macgeeknz/maslowdro/box-layer3.jpg

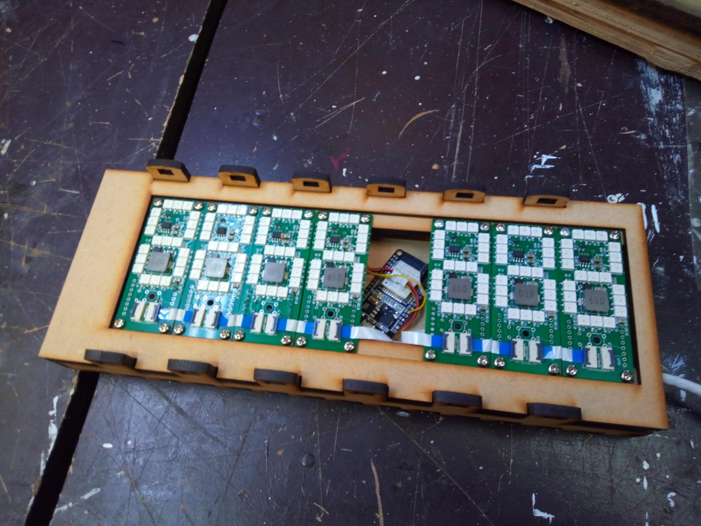
box-layer3.jpg
