macgeeknz/maslowdro/Z.jpg

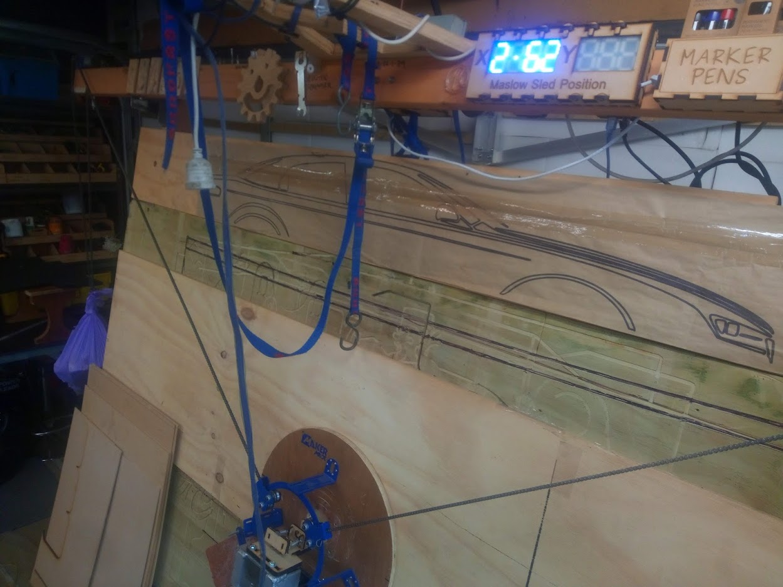
Z.jpg
