macgeeknz/maslowdro/arduino-end.jpg

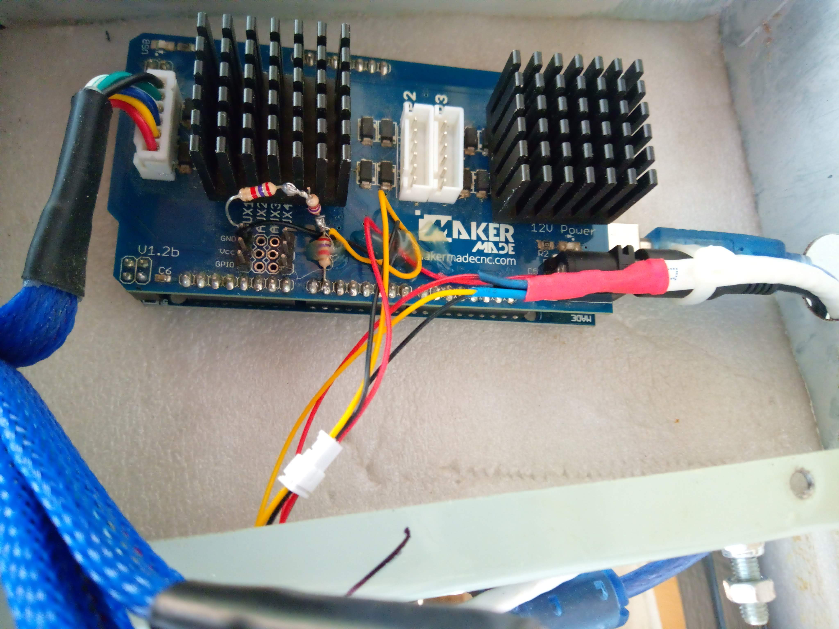
arduino-end.jpg
