macgeeknz/maslowdro/box-layer1.jpg

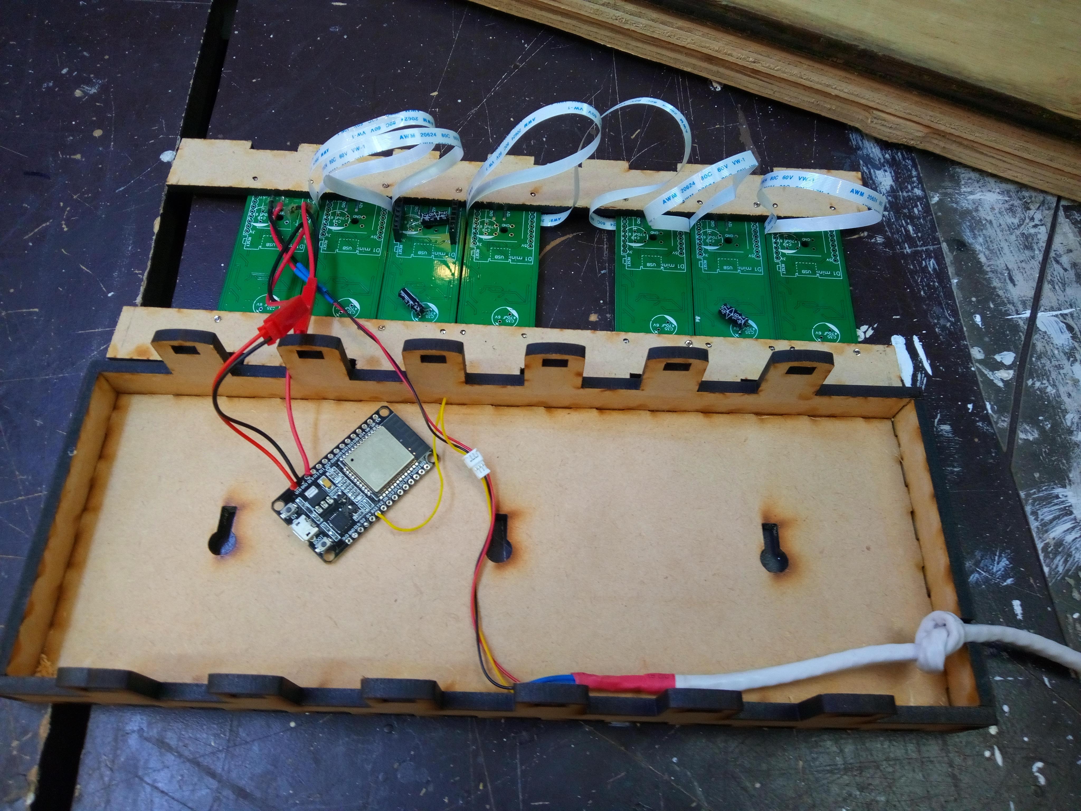
box-layer1.jpg
