macgeeknz/maslowdro/box-layer2.jpg

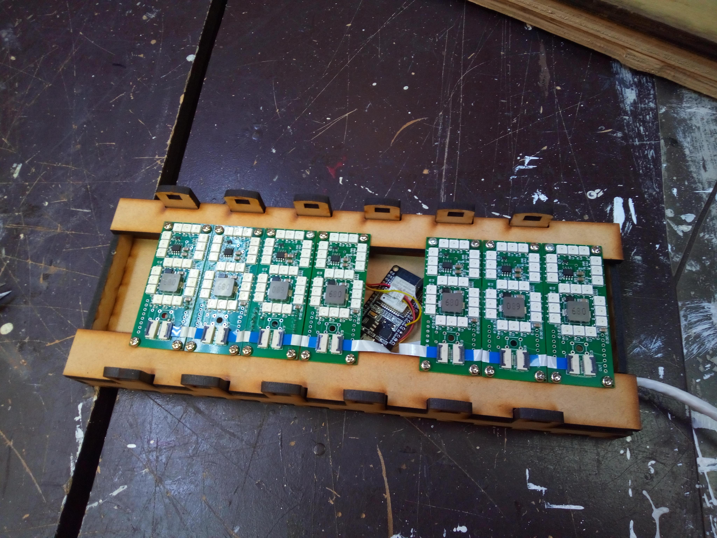
box-layer2.jpg
