macgeeknz/maslowdro/box-layer4.jpg

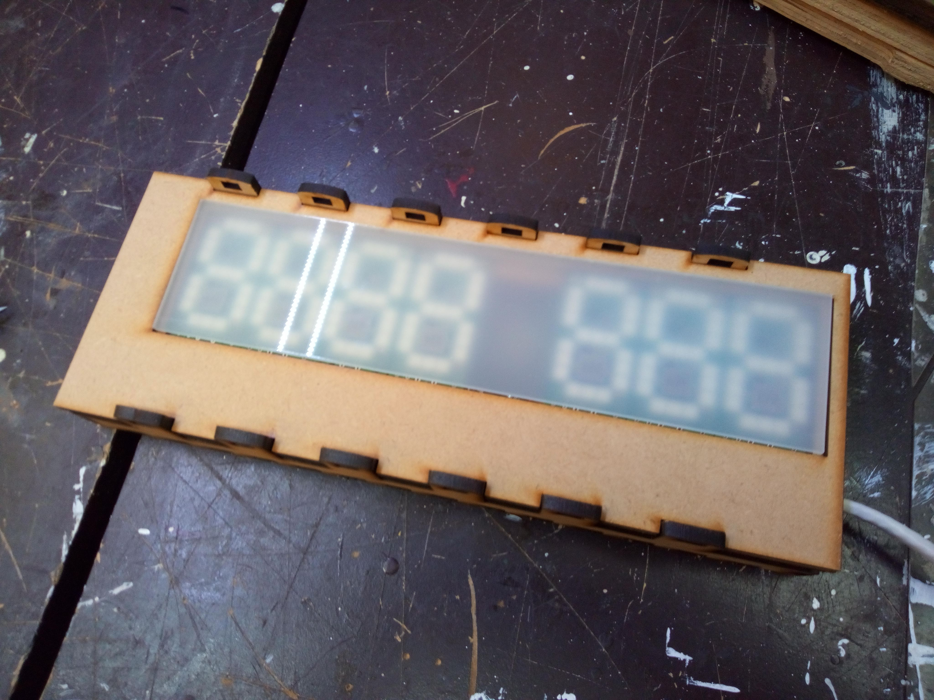
box-layer4.jpg
