macgeeknz/maslowdro/box-layer5.jpg

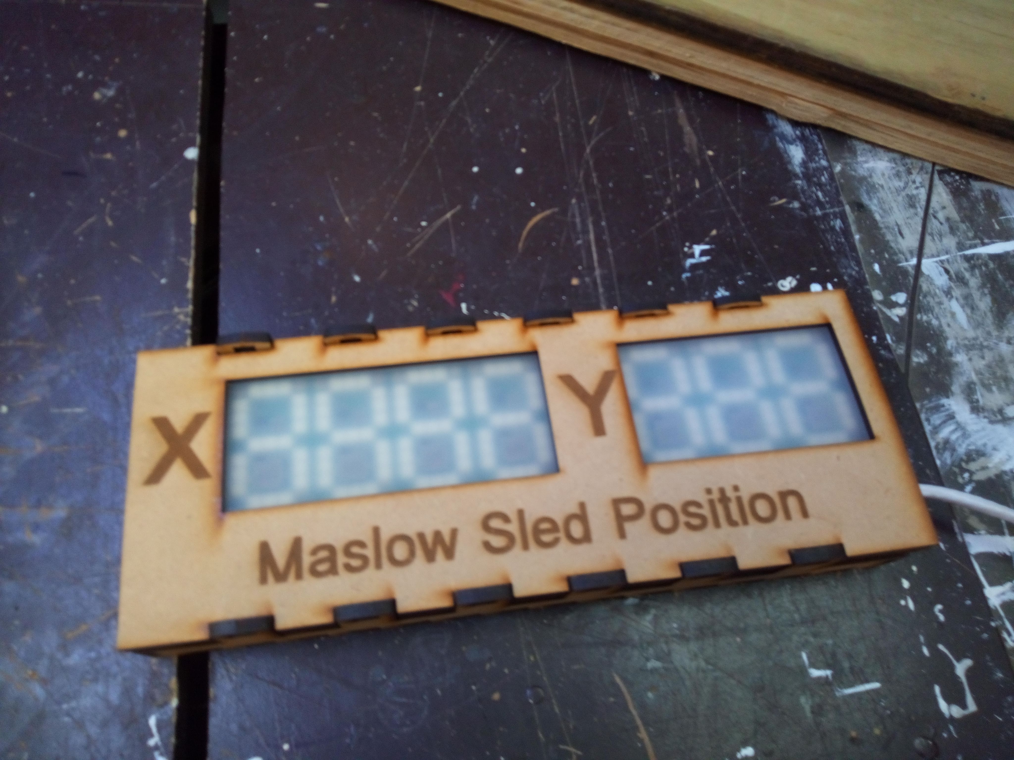
box-layer5.jpg
