macgeeknz/maslowdro/box-layer6.jpg

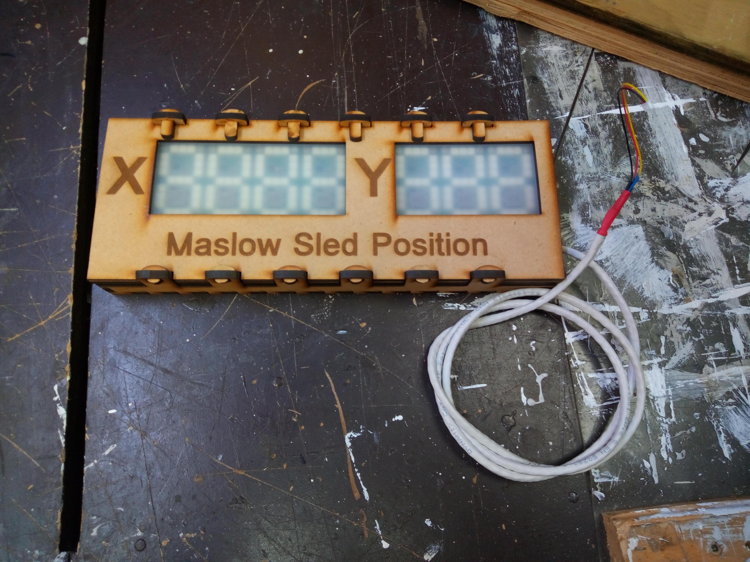
box-layer6.jpg
