macgeeknz/maslowdro/esp32-end.jpg

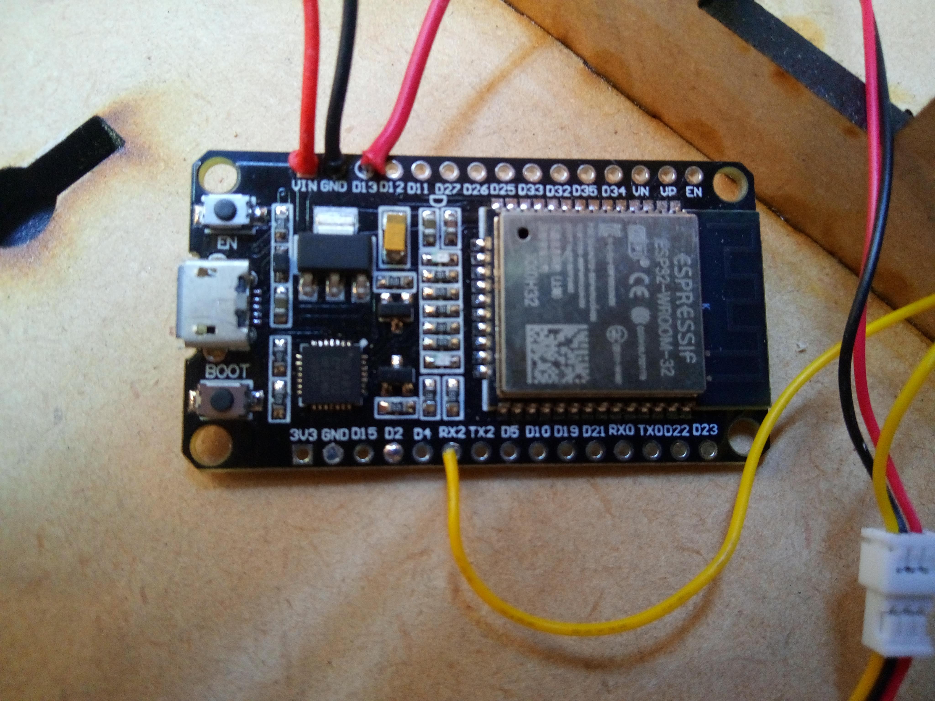
esp32-end.jpg
