macgeeknz/maslowdro/RX-line-resistors.jpg

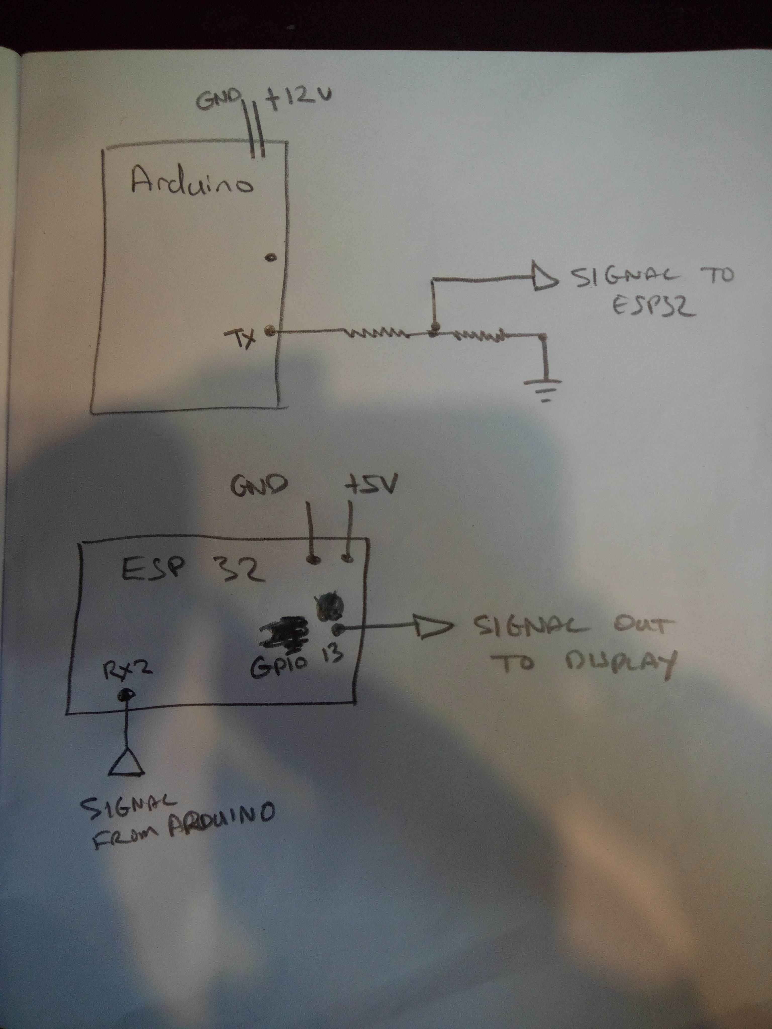
RX-line-resistors.jpg
