macgeeknz/maslowdro/XY.jpg

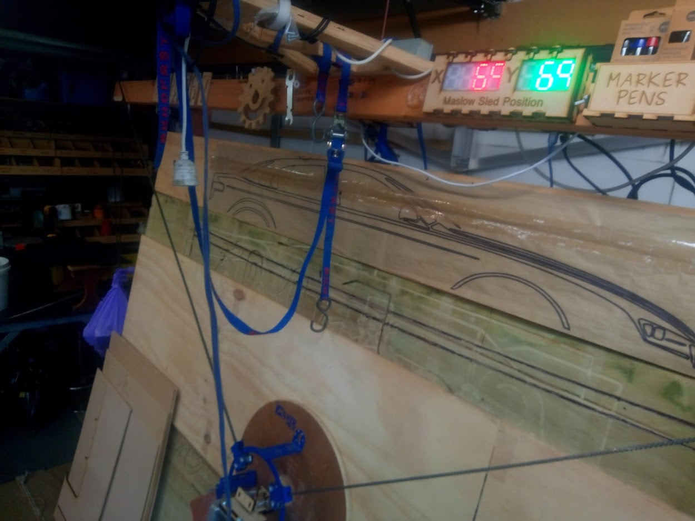
XY.jpg
