macgeeknz/maslowdro/pcb-BOM.csv

ID | Name | Designator | Footprint | Quantity | Manufacturer Part | Manufacturer | Supplier | Supplier Part | Price
1 | F0502-B-10-20T-R | FPC1,FPC2 | FPC-SMD_10P-P0.50_L5.9-W9.4 | 2 | F0502-B-10-20T-R | XFCN | LCSC | C481219 | 0.017
2 | 100uF | C1,C64,C65,C66 | C1206 | 4 | CL31A107MQHNNNE | SAMSUNG | LCSC | C15008 | 0.011
3 | 1uF | C2,C3,C4,C5,C6,C7,C8,C9,C10,C11,C12,C13,C14,C15,C16,C17,C18,C19,C20,C21,C22,C23,C50,C54,C58,C59 | C0402 | 26 | CL05A105KA5NQNC | SAMSUNG | LCSC | C52923 | 0.001
4 | SS34_C8678 | D1 | DO-214AC_L4.3-W2.7-LS5.3-RD | 1 | SS34 | MDD | LCSC | C8678 | 0.005
5 | 68uH | L1 | IND-SMD_L11.5-W10.0_SMMS1040 | 1 | SMMS1040-680MT | ShunXiang Connaught Elec | LCSC | C286354 | 0.042
6 | XL-5050RGBC-WS2812B | LED1,LED2,LED3,LED4,LED5,LED6,LED7,LED8,LED9,LED10,LED11,LED12,LED13,LED14,LED15,LED16,LED17,LED18,LED19,LED20,LED21 | LED-SMD_4P-L5.0-W5.0-BL_XL-5050RGBC | 21 | XL-5050RGBC-WS2812B | XINGLIGHT(成兴光) | LCSC | C2843785 | 0.009
7 | AO3401A | Q4 | SOT-23_L2.9-W1.3-P1.90-LS2.4-BR | 1 | AO3401A | AOS | LCSC | C15127 | 0.014
8 | 10kΩ | R11 | R0402 | 1 | 0402WGF1002TCE | UniOhm | LCSC | C25744
9 | XL1509-5.0E1 | U1 | SOIC-8_L5.0-W4.0-P1.27-LS6.0-BL | 1 | XL1509-5.0E1 | XLSEMI | LCSC | C61063 | 0.03
