macgeeknz/maslowdro/Schematic_1DigitRGBDisplay Rev 2_2023-02-02.pdf

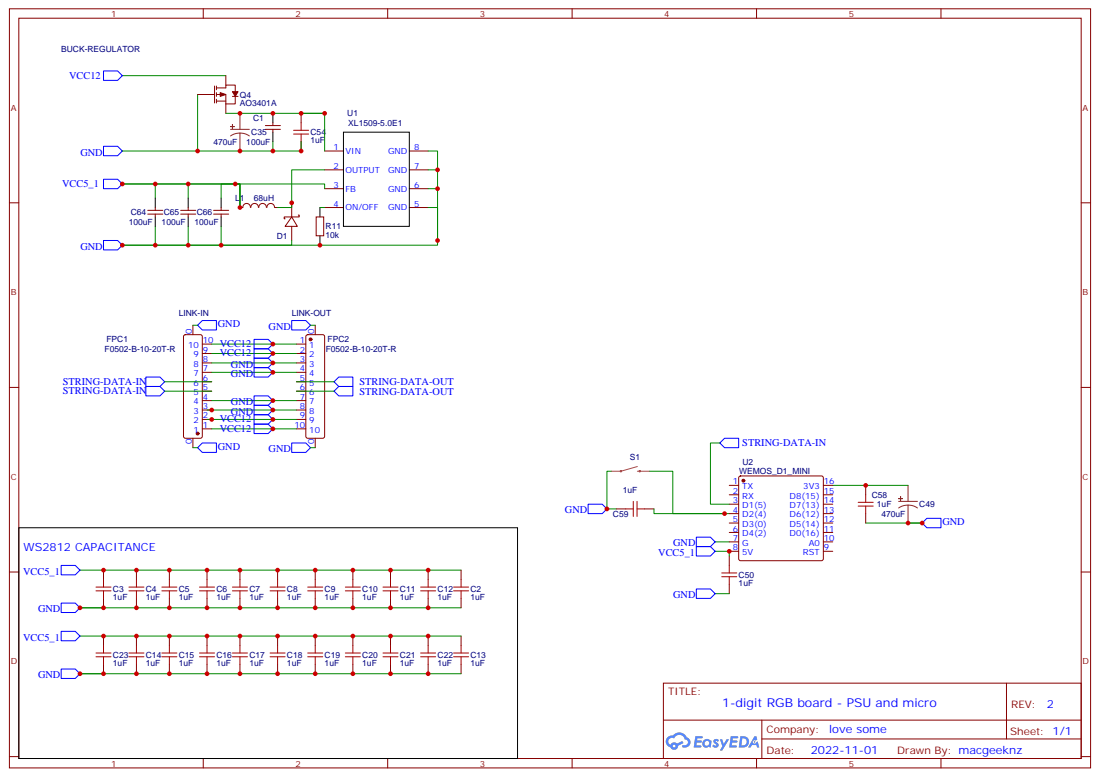
[picture p12: page 1]

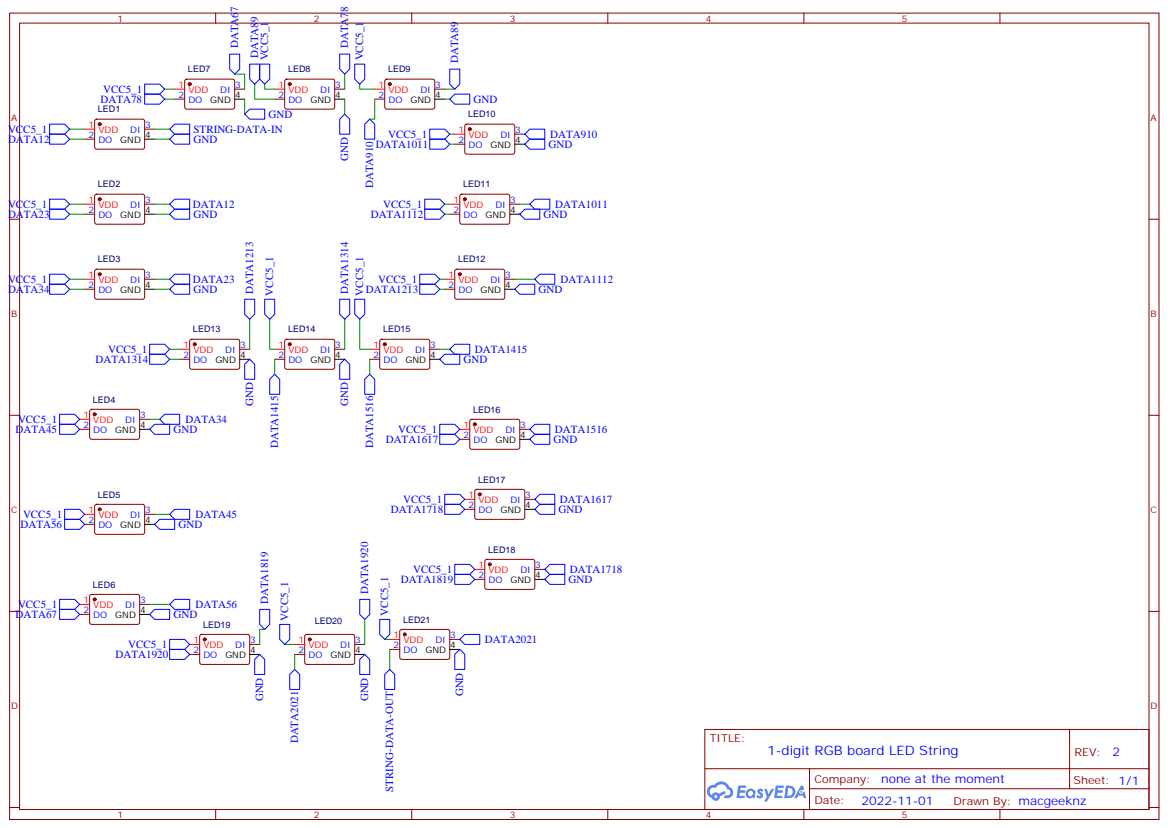
[picture p13: page 2]

Company: none at the moment
