macgeeknz/maslowdro/PCB-bottom.pdf

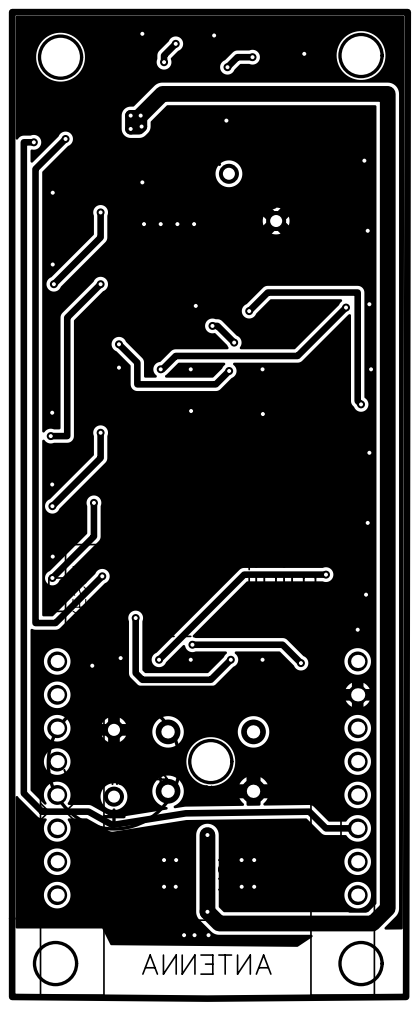
[picture p14: page 1]
