macgeeknz/maslowdro/PCB-top.pdf

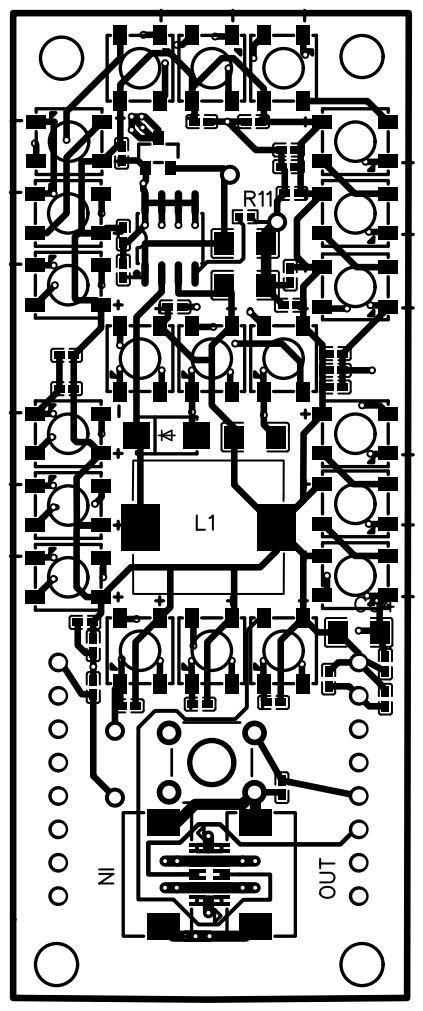
[picture p15: page 1]
